aljerr3/lidar_v2/docs/Diagrama_cableado_LiDAR.png

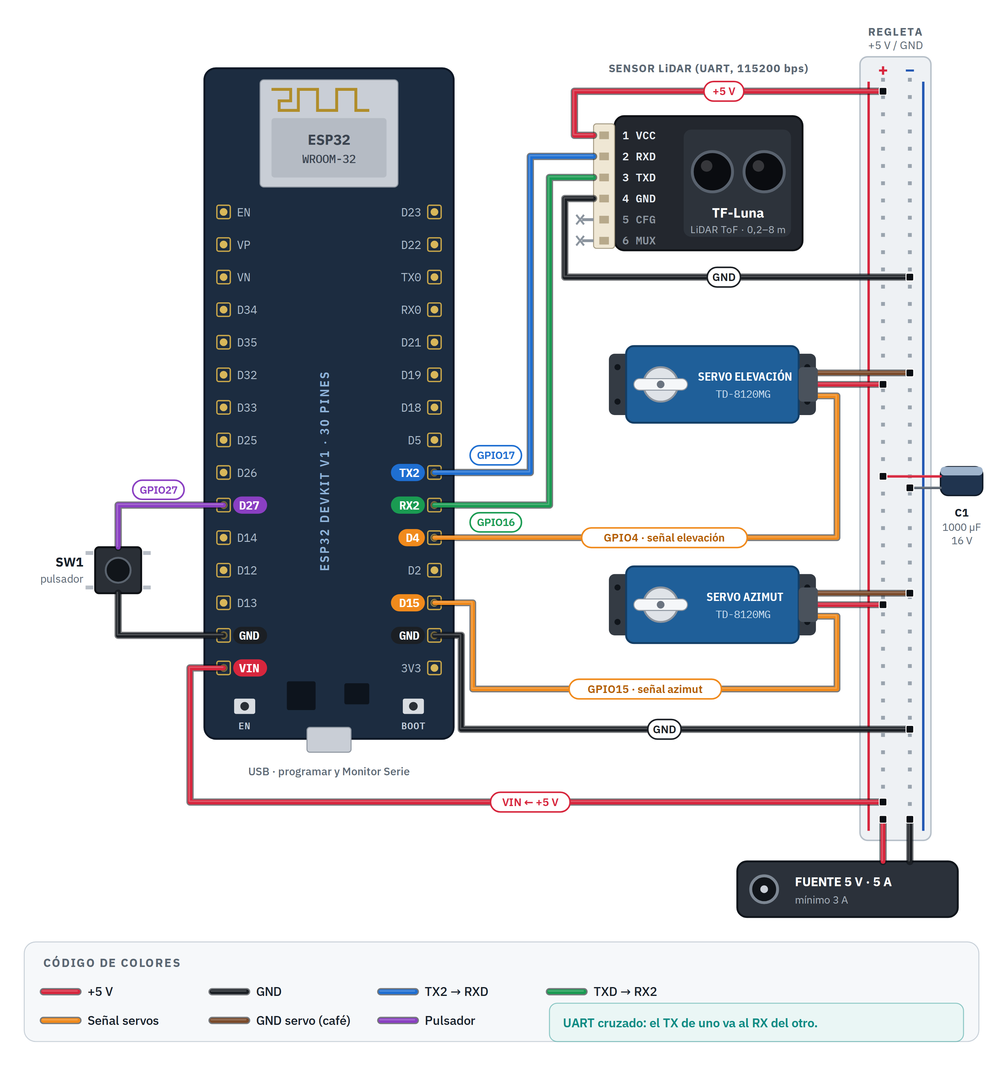
docs/Diagrama_cableado_LiDAR.png
