aljerr3/lidar_v2/docs/Esquematico_LiDAR.png

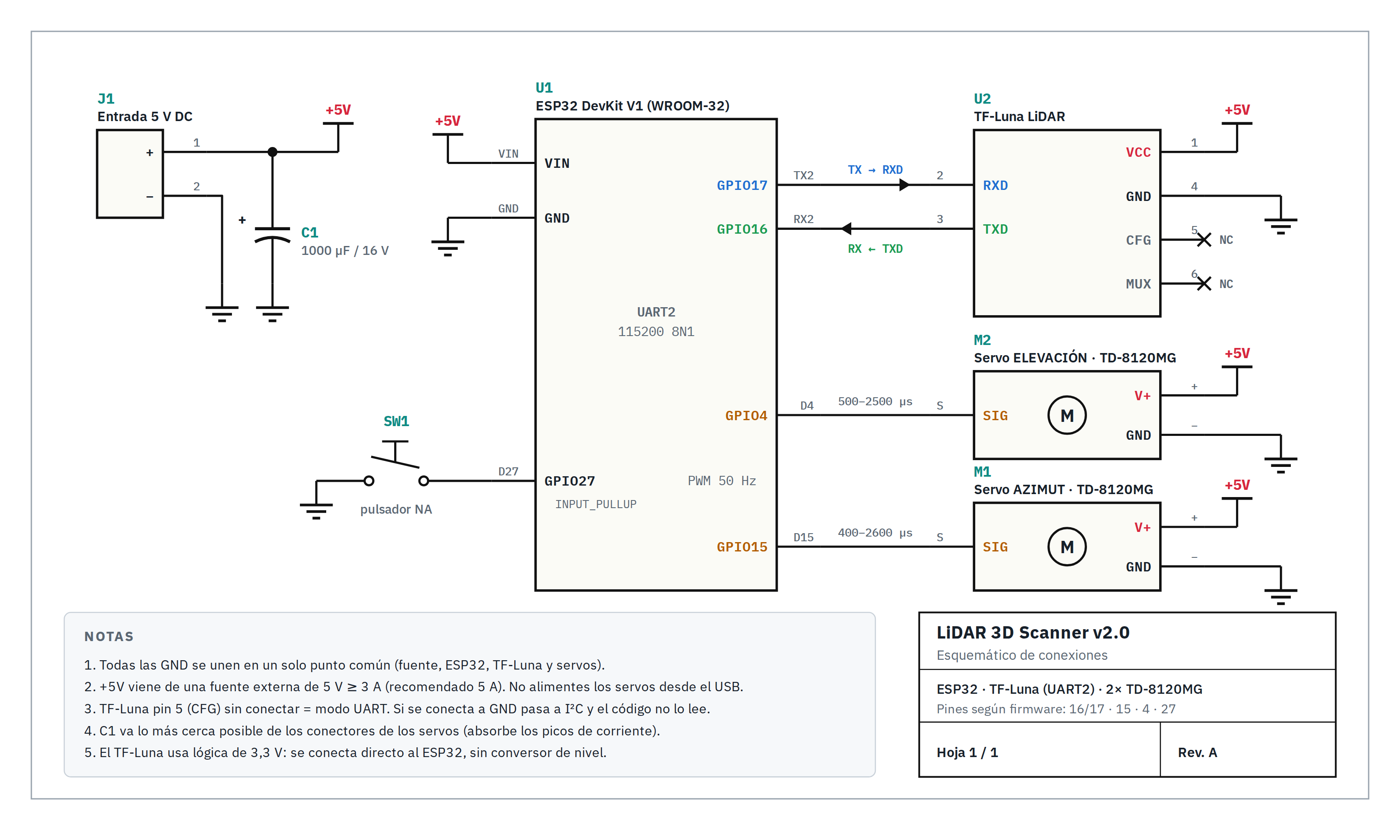
docs/Esquematico_LiDAR.png
